justynbell/leak_detector/hw/Rev A/Home Security PWA-BoM.csv

Reference | Qty | Value | DNP | Exclude from BOM | Exclude from Board | Footprint | Datasheet
C1,C2,C3 | 3 | .1uF |  |  |  | Capacitor_SMD:C_0805_2012Metric_Pad1.18x1.45mm_HandSolder | ~
J1,J2 | 2 | Conn_01x10_Pin |  |  |  | footprint:PPTC101LFBN-RC | ~
J3,J4,J5,J6,J7,J8,J9,J10,J11,J12,J13,J14,J15,J16,J17,J18,J19,J20,J21,J22,J23,J24,J25,J26,J27,J28,J29,J30,J31,J32,J33,J34 | 32 | 1825960000 |  |  |  | footprint:CONN_1825960000_WED | 1825960000
R1,R2 | 2 | 4.7K |  |  |  | Resistor_SMD:R_0805_2012Metric_Pad1.20x1.40mm_HandSolder | ~
R3,R4,R5,R6,R7,R8,R9,R10 | 8 | 10K |  |  |  | Resistor_SMD:R_0805_2012Metric_Pad1.20x1.40mm_HandSolder | ~
TP1,TP2 | 2 | TestPoint |  |  |  | TestPoint:TestPoint_THTPad_D2.0mm_Drill1.0mm | ~
U1,U2 | 2 | ADS1115IDGS |  |  |  | Package_SO:TSSOP-10_3x3mm_P0.5mm | http://www.ti.com/lit/ds/symlink/ads1113.pdf
U3 | 1 | MCP23017_SO |  |  |  | Package_SO:SOIC-28W_7.5x17.9mm_P1.27mm | https://ww1.microchip.com/downloads/aemDocuments/documents/APID/ProductDocuments/DataSheets/MCP23017-Data-Sheet-DS20001952.pdf
