justynbell/leak_detector/hw/Rev A/Home Security PWA.stl

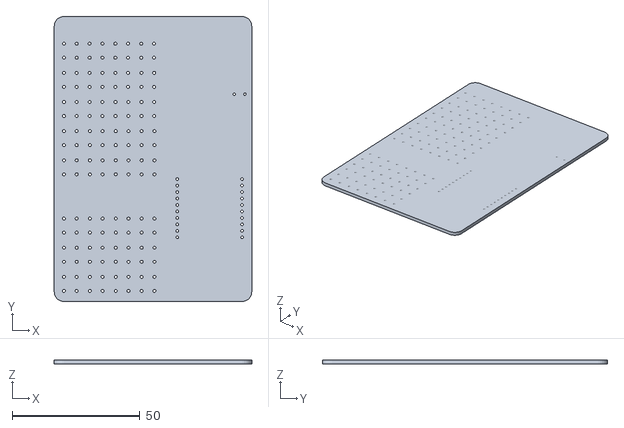
[picture p1: CAD file, 2026-02-09]
hw/Rev A/Home Security PWA.stl
77.5 x 111.8 x 1.51
