justynbell/leak_detector/mech/leak_detector.FCStd

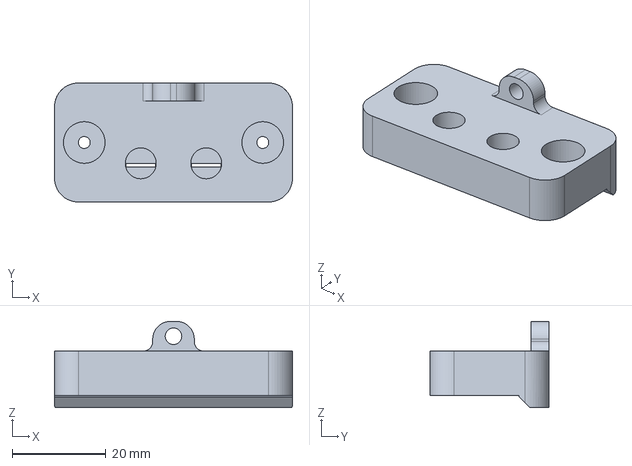
[picture p2: CAD file, 2026-02-07]
mech/leak_detector.FCStd
50.8 x 25.4 x 18.4 mm
