justynbell/leak_detector/hw/Components/model/PPTC101LFBN-RC.STEP

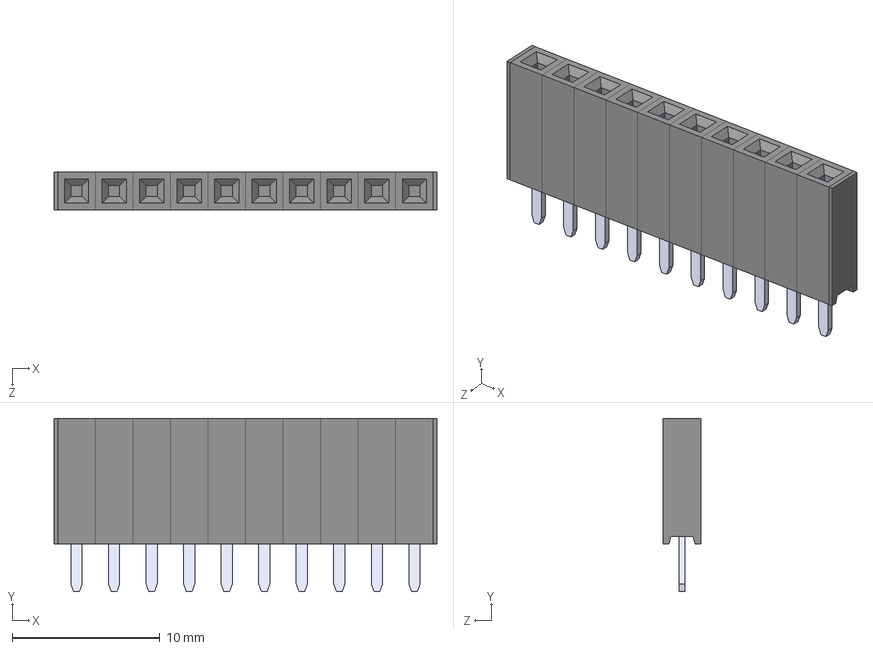
[picture p3: CAD file, 2026-02-08]
hw/Components/model/PPTC101LFBN-RC.STEP
25.9 x 11.7 x 2.54 mm
PPPC021LFBN-RC_C10
Pin - Tin x 10
