justynbell/leak_detector/hw/Components/model/SOIC28-W_MC_MCH.step

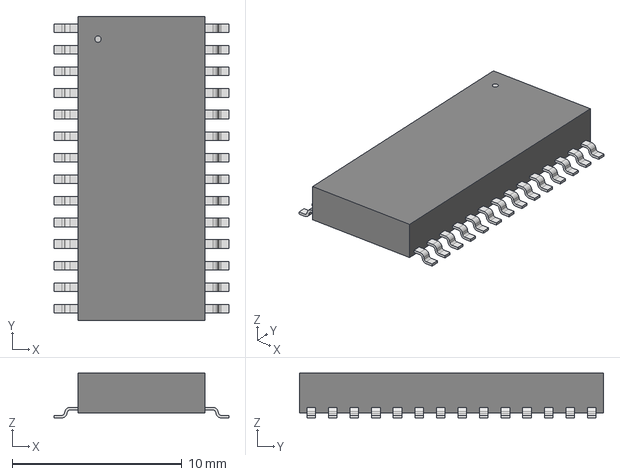
[picture p4: CAD file, 2026-02-08]
hw/Components/model/SOIC28-W_MC_MCH.step
10.3 x 17.9 x 2.64 mm
