justynbell/leak_detector/hw/Components/model/1825960000.STEP

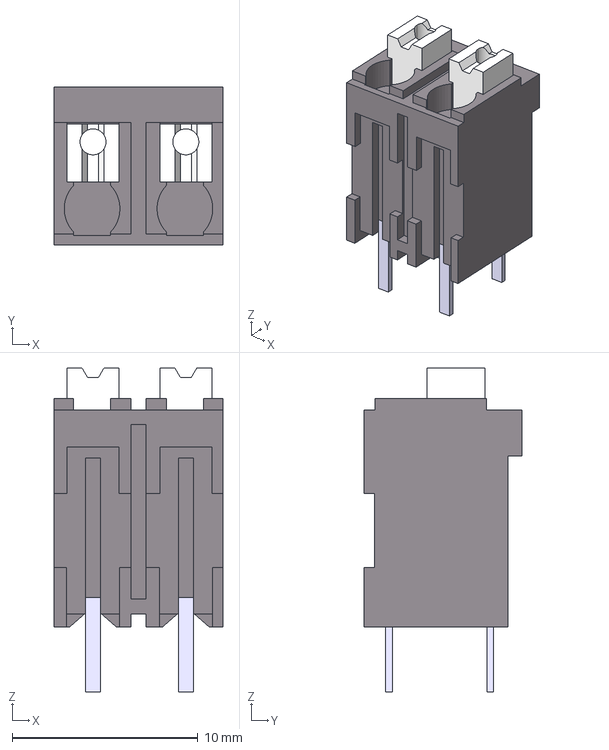
[picture p5: CAD file, 2026-02-09]
hw/Components/model/1825960000.STEP
9.10 x 8.50 x 17.4 mm
