justynbell/leak_detector/hw/Components/model/1884340000.stp

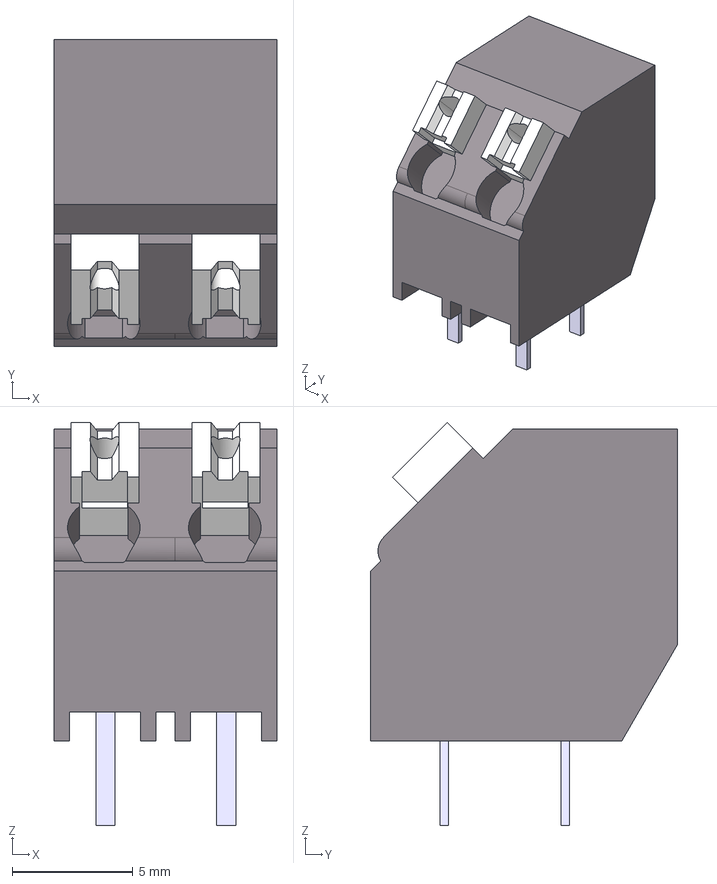
[picture p6: CAD file, 2026-02-08]
hw/Components/model/1884340000.stp
9.20 x 12.7 x 16.7 mm
