justynbell/leak_detector/hw/Rev A/Home Security PWA-Schematic.pdf

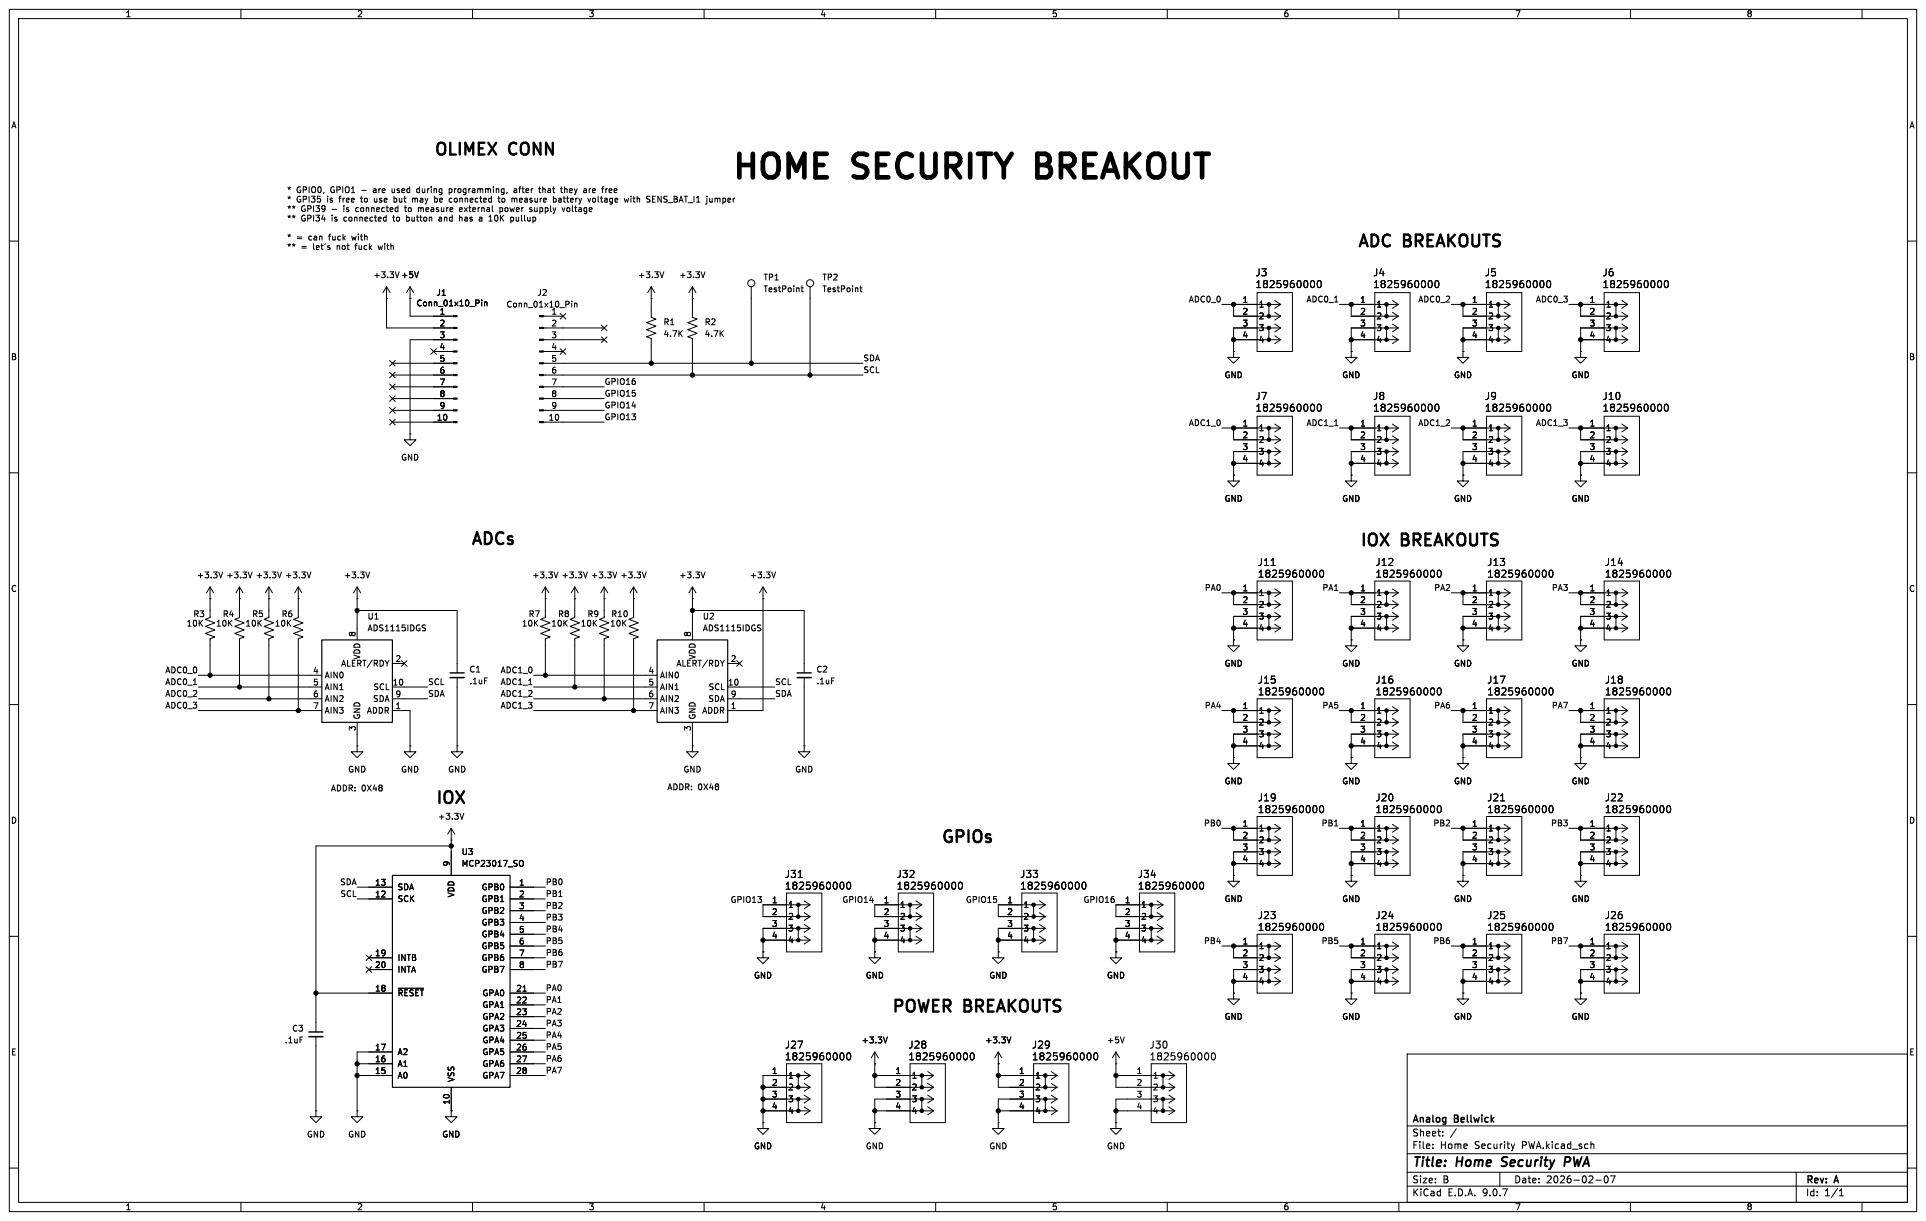
[picture p7: page 1]

3 ALERT/RDY 2 SCL 10 SDA 9 ADDR 1 U1ADS1115IDGS GND

3 ALERT/RDY 2 SCL 10 SDA 9 ADDR 1 U2ADS1115IDGS

Id: 1/1 Title: Home Security PWA
