justynbell/leak_detector/hw/Home Security PWA/Home Security PWA.kicad_pcb

## KiCad design hw/Home Security PWA/Home Security PWA.kicad_pcb (2026-02-09)

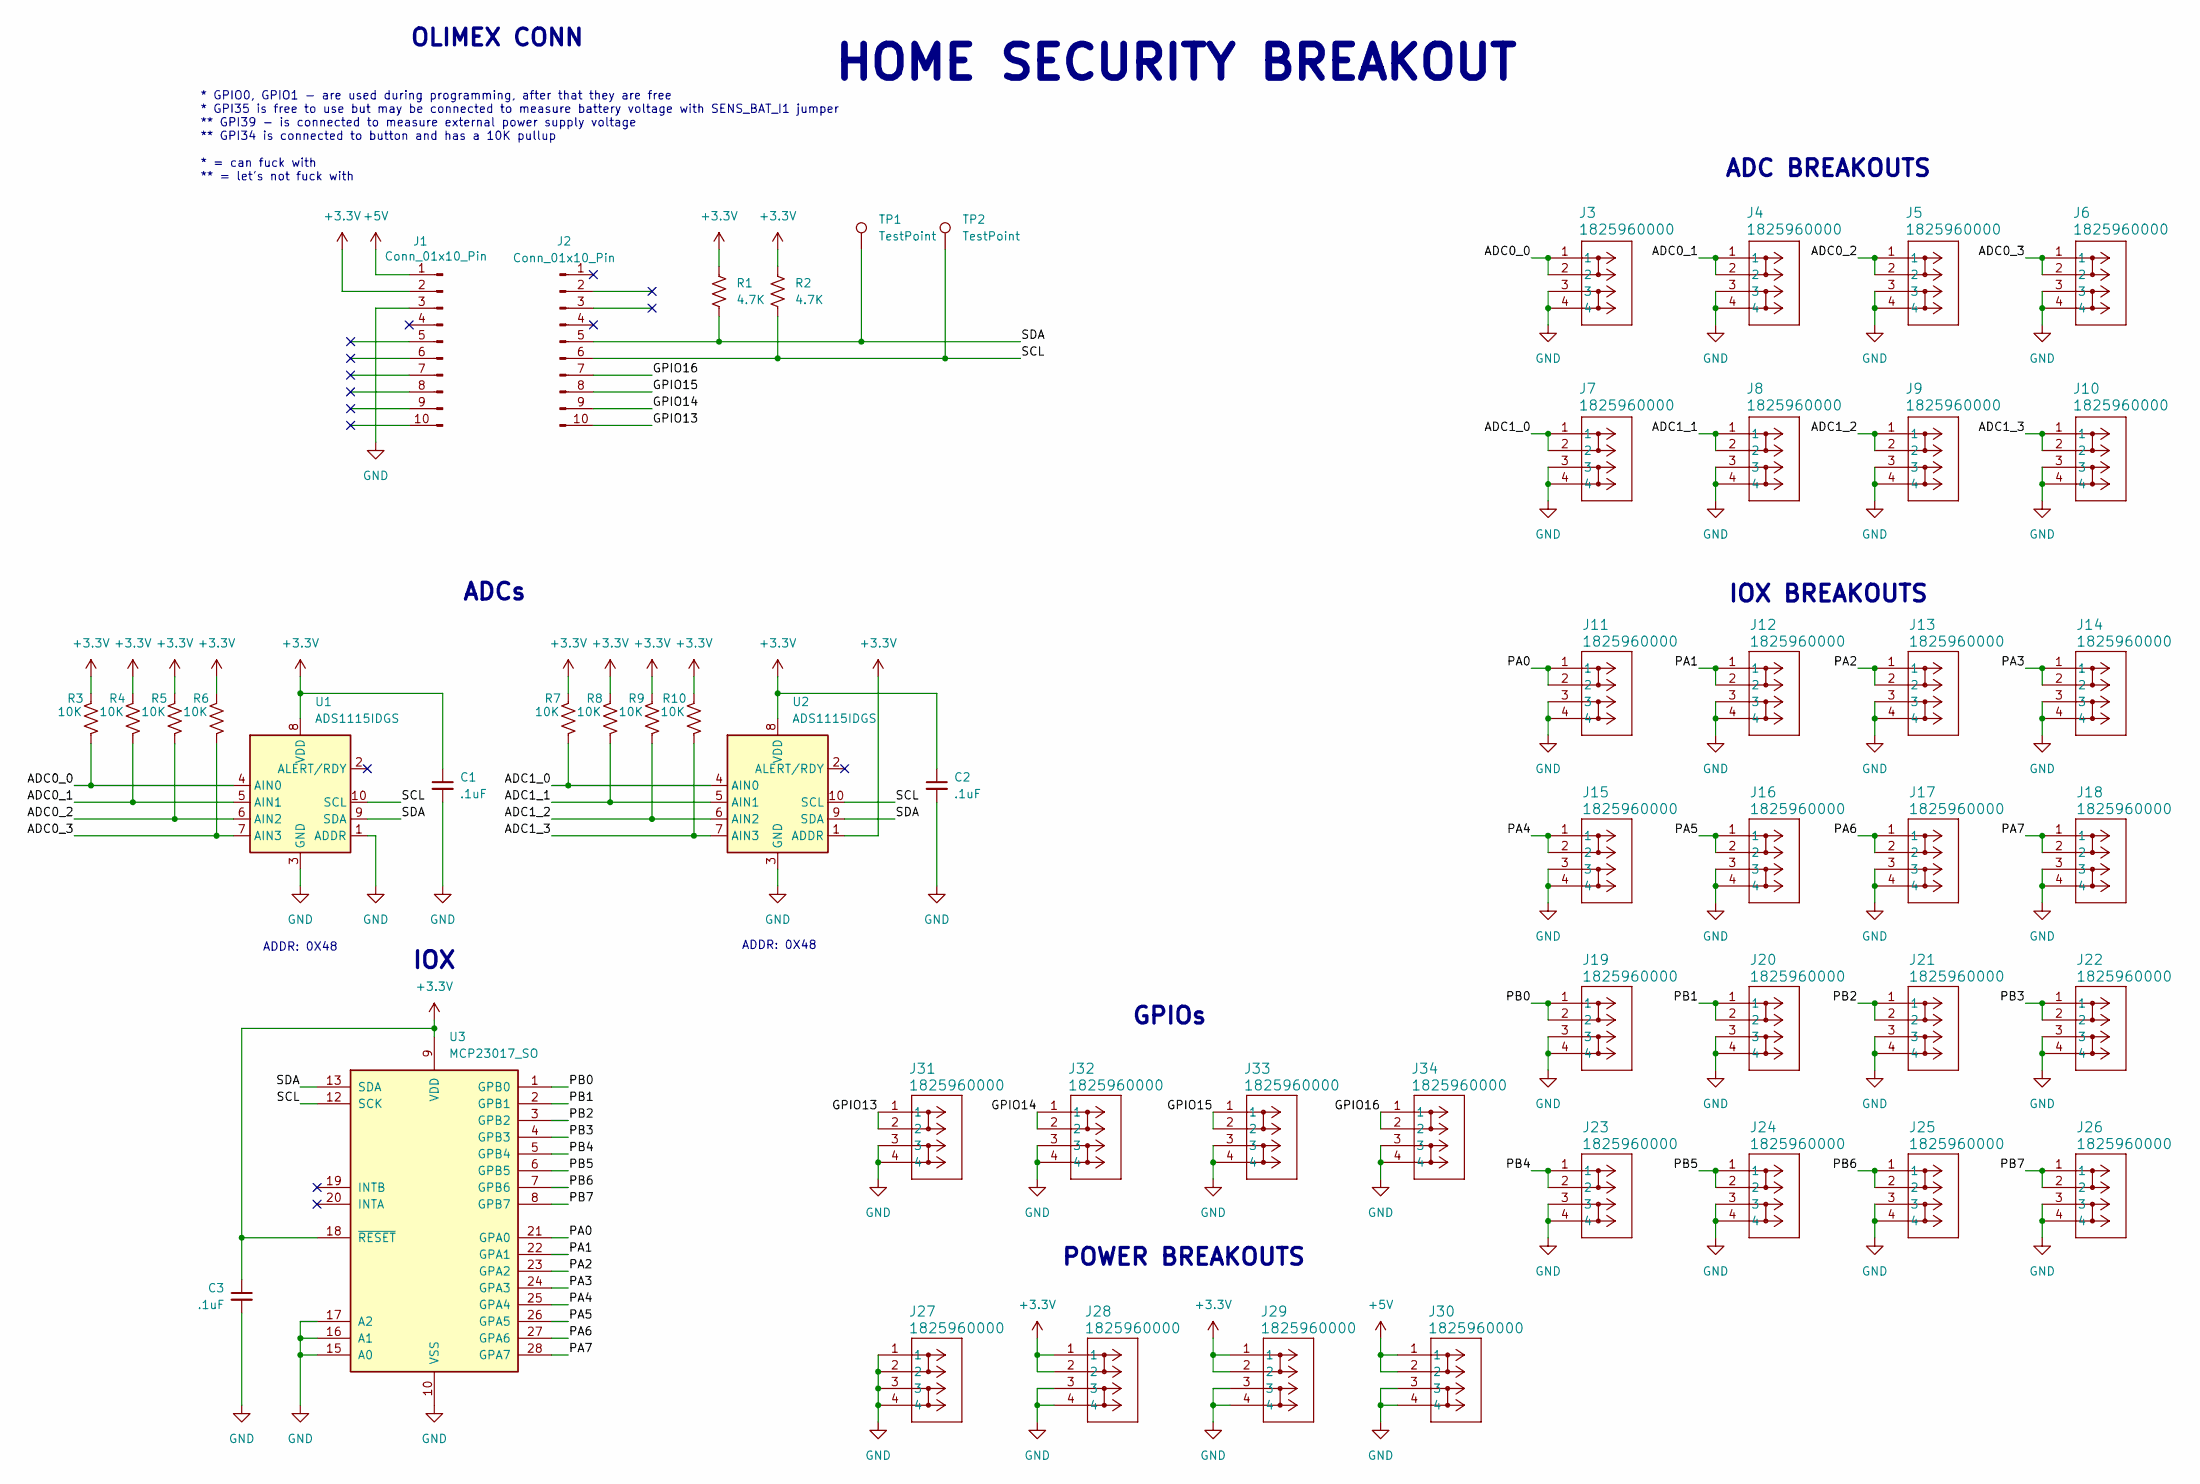
[picture p8: schematic Home Security PWA.kicad_sch]

Parts:
C1, C2, C3: .1uF; C_0805_2012Metric_Pad1.18x1.45mm_HandSolder
J1, J2: Conn_01x10_Pin; PPTC101LFBN-RC
J3, J4, J5, J6, J7, J8, J9, J10, J11, J12, J13, J14, J15, J16, J17, J18, J19, J20, J21, J22, J23, J24, J25, J26, J27, J28, J29, J30, J31, J32, J33, J34: 1825960000; CONN_1825960000_WED
R1, R2: 4.7K; R_0805_2012Metric_Pad1.20x1.40mm_HandSolder
R3, R4, R5, R6, R7, R8, R9, R10: 10K; R_0805_2012Metric_Pad1.20x1.40mm_HandSolder
TP1, TP2: TestPoint; TestPoint_THTPad_D2.0mm_Drill1.0mm
U1, U2: ADS1115IDGS; TSSOP-10_3x3mm_P0.5mm
U3: MCP23017_SO; SOIC-28W_7.5x17.9mm_P1.27mm

Connections:
+3.3V: C1.1, C2.1, C3.1, J1.2, J28.1, J28.2, J29.1, J29.2, R1.1, R2.1, R3.1, R4.1, R5.1, R6.1, R7.1, R8.1, R9.1, R10.1, U1.8 (VDD), U2.1 (ADDR), U2.8 (VDD), U3.9 (VDD), U3.18 (~RESET)
+5V: J1.1, J30.1, J30.2
/ADC0_0: J3.1, J3.2, R3.2, U1.4 (AIN0)
/ADC0_1: J4.1, J4.2, R4.2, U1.5 (AIN1)
/ADC0_2: J5.1, J5.2, R5.2, U1.6 (AIN2)
/ADC0_3: J6.1, J6.2, R6.2, U1.7 (AIN3)
/ADC1_0: J7.1, J7.2, R7.2, U2.4 (AIN0)
/ADC1_1: J8.1, J8.2, R8.2, U2.5 (AIN1)
/ADC1_2: J9.1, J9.2, R9.2, U2.6 (AIN2)
/ADC1_3: J10.1, J10.2, R10.2, U2.7 (AIN3)
/GPIO13: J2.10, J31.1, J31.2
/GPIO14: J2.9, J32.1, J32.2
/GPIO15: J2.8, J33.1, J33.2
/GPIO16: J2.7, J34.1, J34.2
/PA0: J11.1, J11.2, U3.21 (GPA0)
/PA1: J12.1, J12.2, U3.22 (GPA1)
/PA2: J13.1, J13.2, U3.23 (GPA2)
/PA3: J14.1, J14.2, U3.24 (GPA3)
/PA4: J15.1, J15.2, U3.25 (GPA4)
/PA5: J16.1, J16.2, U3.26 (GPA5)
/PA6: J17.1, J17.2, U3.27 (GPA6)
/PA7: J18.1, J18.2, U3.28 (GPA7)
/PB0: J19.1, J19.2, U3.1 (GPB0)
/PB1: J20.1, J20.2, U3.2 (GPB1)
/PB2: J21.1, J21.2, U3.3 (GPB2)
/PB3: J22.1, J22.2, U3.4 (GPB3)
/PB4: J23.1, J23.2, U3.5 (GPB4)
/PB5: J24.1, J24.2, U3.6 (GPB5)
/PB6: J25.1, J25.2, U3.7 (GPB6)
/PB7: J26.1, J26.2, U3.8 (GPB7)
/SCL: J2.6, R2.2, TP2.1, U1.10 (SCL), U2.10 (SCL), U3.12 (SCK); also elsewhere on the board
/SDA: J2.5, R1.2, TP1.1, U1.9 (SDA), U2.9 (SDA), U3.13 (SDA); also elsewhere on the board
GND: C1.2, C2.2, C3.2, J1.3, J3.3, J3.4, J4.3, J4.4, J5.3, J5.4, J6.3, J6.4, J7.3, J7.4, J8.3, J8.4, J9.3, J9.4, J10.3, J10.4, J11.3, J11.4, J12.3, J12.4, J13.3, J13.4, J14.3, J14.4, J15.3, J15.4, J16.3, J16.4, J17.3, J17.4, J18.3, J18.4, J19.3, J19.4, J20.3, J20.4, J21.3, J21.4, J22.3, J22.4, J23.3, J23.4, J24.3, J24.4, J25.3, J25.4, J26.3, J26.4, J27.1, J27.2, J27.3, J27.4, J28.3, J28.4, J29.3, J29.4, J30.3, J30.4, J31.3, J31.4, J32.3, J32.4, J33.3, J33.4, J34.3, J34.4, U1.1 (ADDR), U1.3 (GND), U2.3 (GND), U3.10 (VSS), U3.15 (A0), U3.16 (A1), U3.17 (A2)

Notes on the sheet:
GPIOs
HOME SECURITY BREAKOUT
ADC BREAKOUTS
IOX
ADDR: 0X48
IOX BREAKOUTS
OLIMEX CONN
POWER BREAKOUTS
ADCs
* GPIO0, GPIO1 - are used during programming, after that they are free * GPI35 is free to use but may be connected to measure battery voltage with SENS_BAT_I1 jumper ** GPI39 - is connected to measure external power supply voltage ** GPI34 is connected to button and has a 10K pullup * = can fuck wi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

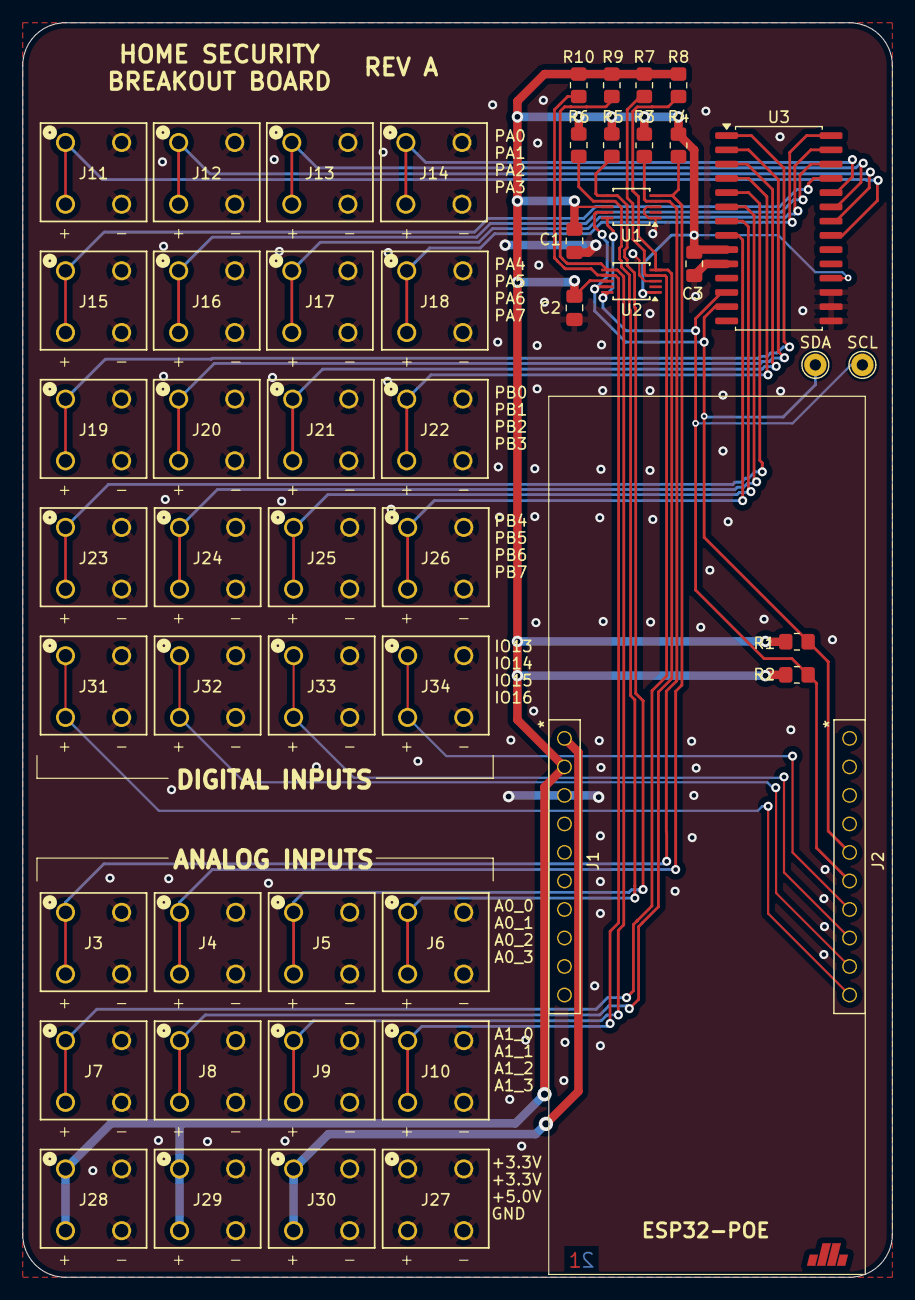
[picture p9: board Home Security PWA.kicad_pcb from above]

Board: 2 copper layers, 77.5 x 111.8 mm, 52 parts (0 on the bottom side), 33 nets.

Other parts of the board:
SCL: TestPoint; TestPoint_THTPad_D2.0mm_Drill1.0mm
SDA: TestPoint; TestPoint_THTPad_D2.0mm_Drill1.0mm

Their connections:
/SCL: SCL.1; also elsewhere on the board
/SDA: SDA.1; also elsewhere on the board
