justynbell/leak_detector/(commit log)

2026-02-04 First cut at leak detector hardware
    [leak_detector.FCStd]
2026-02-07 Second iteration of leak detector HW.
    Added docs.
    [leak_detector.FCStd]
2026-02-08 Adding hw/ and sw/
    SW is first (complete) cut.
    HW is a work in progress.
    [1884340000.stp, Home Security PWA.kicad_pcb, Home Security PWA.kicad_sch, PPTC101LFBN-RC.STEP, SOIC28-W_MC_MCH.step, leak_detector.FCStd]
2026-02-08 Design and layout done.
    [Home Security PWA.kicad_pcb, Home Security PWA.kicad_sch]
2026-02-08 Restructuring hw directory.
    [1884340000.stp, Home Security PWA.kicad_pcb, Home Security PWA.kicad_sch, PPTC101LFBN-RC.STEP, SOIC28-W_MC_MCH.step]
2026-02-09 Rev A.
    Added these "top" loader cable holders.
    Added GPIOs that directly attach to the ESP32.
    [1825960000.STEP, Home Security PWA-BoM.csv, Home Security PWA.kicad_pcb, Home Security PWA.kicad_sch, Home Security PWA.stl]
